yobbas2401/Sistema_de_monitoreo_de_fugas/Diagrama de conexiones/Programacion_inalambrica_de_Arduino_por_Bluetooth-768x578.jpg

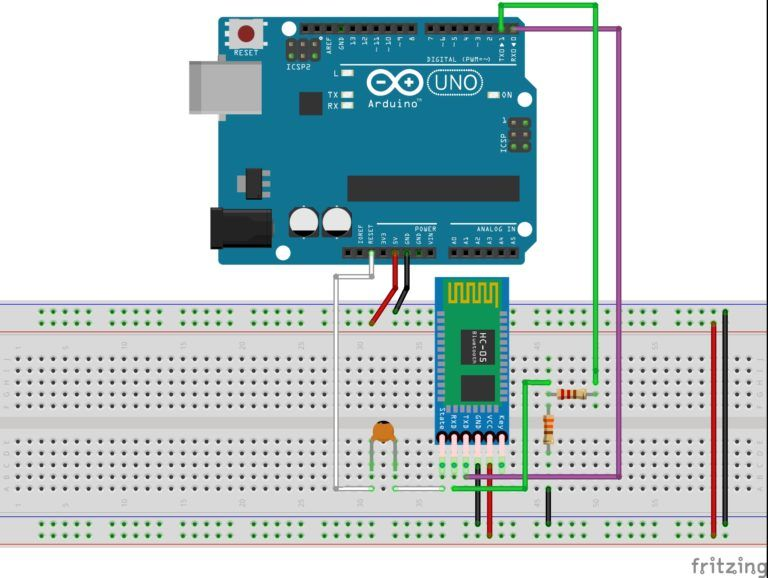
Diagrama de conexiones/Programacion_inalambrica_de_Arduino_por_Bluetooth-768x578.jpg
