yobbas2401/Sistema_de_monitoreo_de_fugas/README.md

# Sistema_de_monitoreo_de_fugas
Diseño de software para monitoreo de sensores
