yobbas2401/Sistema_de_monitoreo_de_fugas/instrumentos/CONVERTIDORES DE VOLTAJE A CORRIENTE.docx

CONVERTIDORES DE SEÑAL PARA RIEL DIN
NOMBRE | UBICACIÓN | PRECIO | MARCA
Acondicionador de señal de montaje sobre riel DIN (DRG-SC) | https://mx.omega.com/pptst/DRG-SC.html | 9,235.00 | OMEGA
Acondicionador de señales (DRF-PR) | https://mx.omega.com/pptst/DRF-PR.html | 5,190.00 | OMEGA
