yobbas2401/Sistema_de_monitoreo_de_fugas/instrumentos/sensor_presion/HL100D.pdf

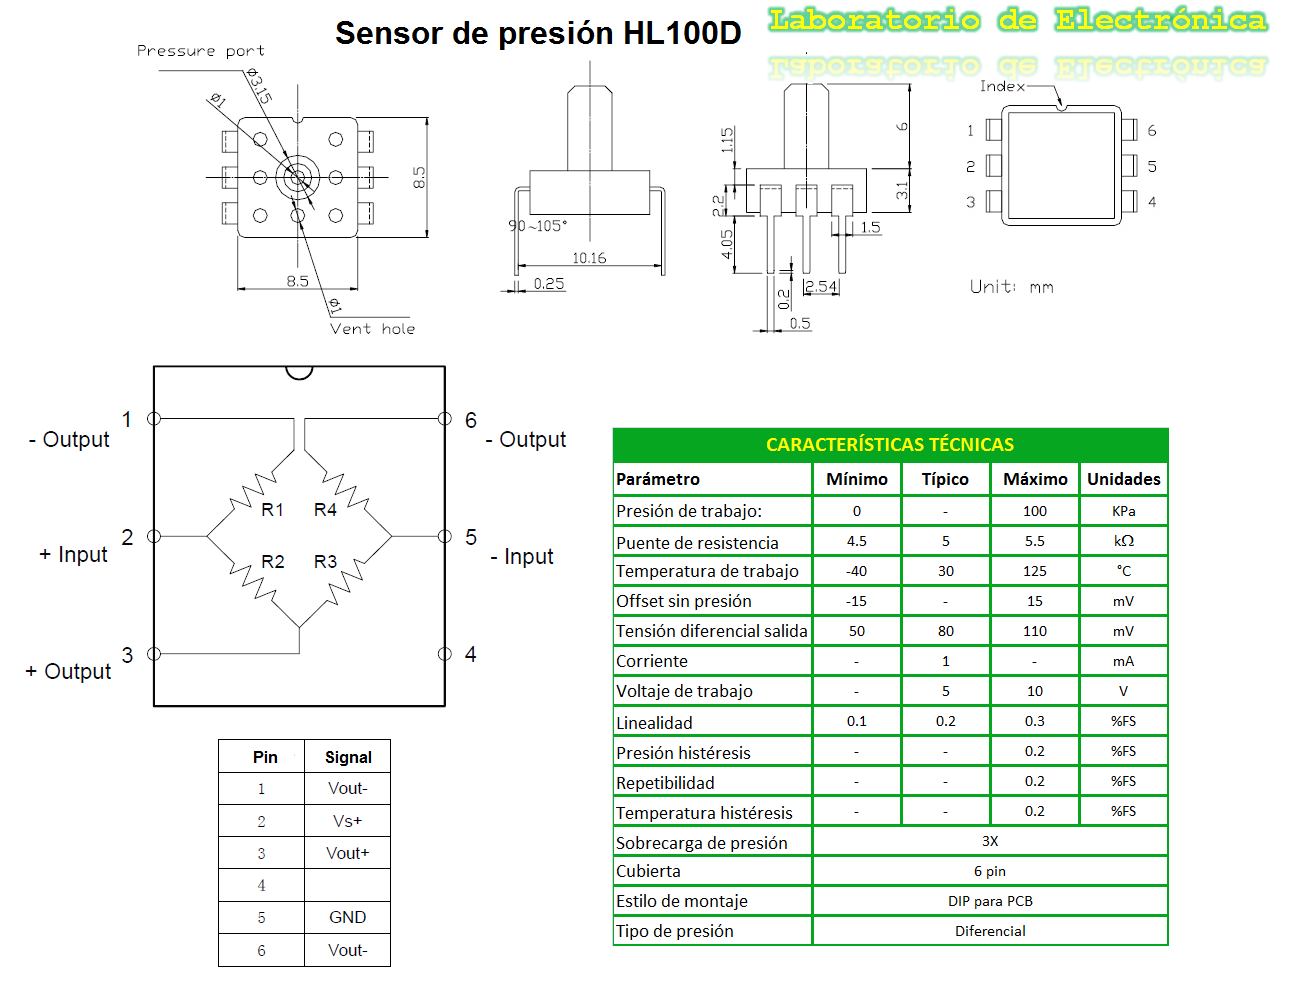
[picture p56: page 1]
