yobbas2401/Sistema_de_monitoreo_de_fugas/Diagrama de conexiones/9.jpg

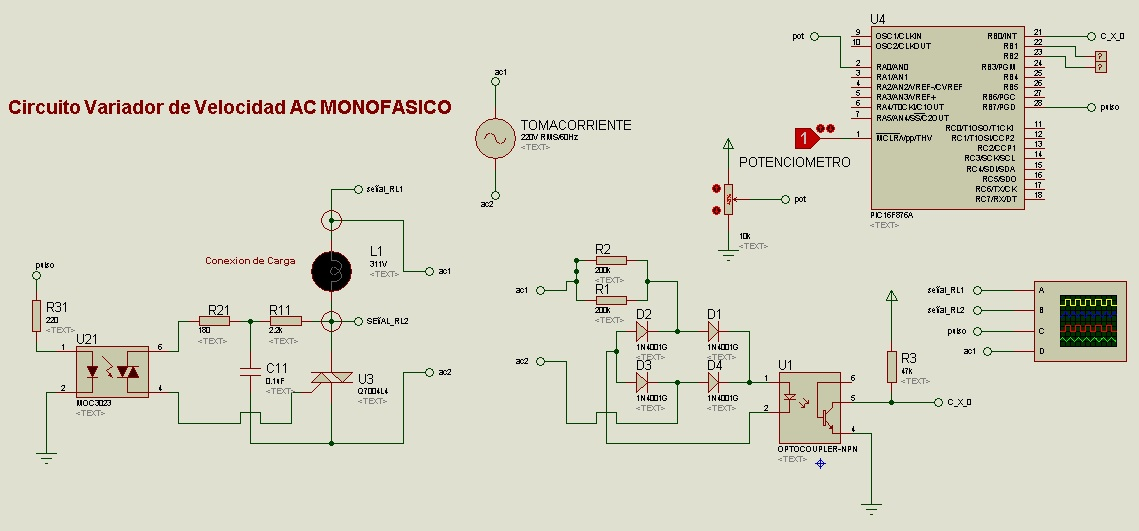
Diagrama de conexiones/9.jpg
