yobbas2401/Sistema_de_monitoreo_de_fugas/Diagrama de conexiones/dimmer_control_vel_motor.png

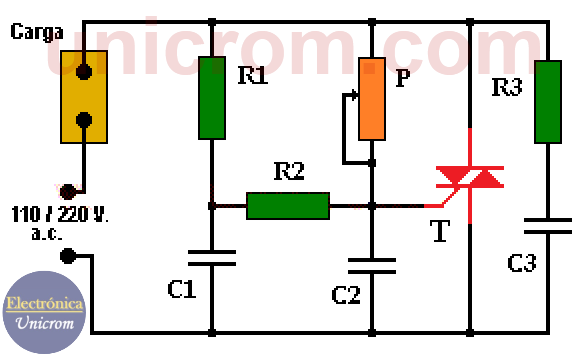
Diagrama de conexiones/dimmer_control_vel_motor.png
