yobbas2401/Sistema_de_monitoreo_de_fugas/instrumentos/LISTA DE COMPONENTES ELECTRONICOS.docx

Nombre | Ubicación | Precio | marca
Modulo dimmer ac para Arduino, 1 canal 127/220v 16a | https://articulo.mercadolibre.com.mx/MLM-606103804-modulo-dimmer-ac-para-arduino-1-canal-127220v-16a-_JM | 265
Sensor analógico, presión agua, aire 1.2 mpa rosca g 1/4 | https://articulo.mercadolibre.com.mx/MLM-553112386-sensor-analogico-5v-presion-agua-aire-12mpa-174psi-g14-_JM
Caudal metro sensor de flujo liquidos 1 pulgada 1 a 60 l/min | https://articulo.mercadolibre.com.mx/MLM-563607650-caudalimetro-sensor-de-flujo-liquidos-1-pulgada-1-a-60-lmin-_JM https://jdhlabstech.com/jdhshop/es/sensores-de-caudal-control/152-sensor-de-flujo-de-agua-caudalimetro-1-a-60-litrosmin-para-tuberia-de-1-pulgada.html | $348 $186.33 | SEA
Sensor de presión transductor gas/líquidos 0-5v. Acero inoxidable aplicaciones industriales. 100kpa / 200kpa / 500kpa/ 1mpa | https://jdhlabstech.com/jdhshop/es/sensores-de-presion/105-sensor-de-presion-para-gasliquidos-0-5v-cuerpo-de-acero-inoxidable-aplicaciones-industriales-100kpa-200kpa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 | $777.33
Convertidor de voltaje a corriente | https://articulo.mercadolibre.com.mx/MLM-636041373-knacro-voltaje-en-corriente-modulo-0-25v-33v-5v-10v-15v-2-_JM | $590 | KNACRO
Xtr110 | https://www.mouser.mx/ProductDetail/Texas-Instruments/XTR110KP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 | 369.28 | TEXAS INSTRUMENTS
Mpx5010 | https://www.mouser.mx/_/?Keyword=MPX5010&FS=True | 501.60 | NXP/FRRESCALE
