yobbas2401/Sistema_de_monitoreo_de_fugas/componentes hmi monitoreo de fugas labview/bomba_on.png

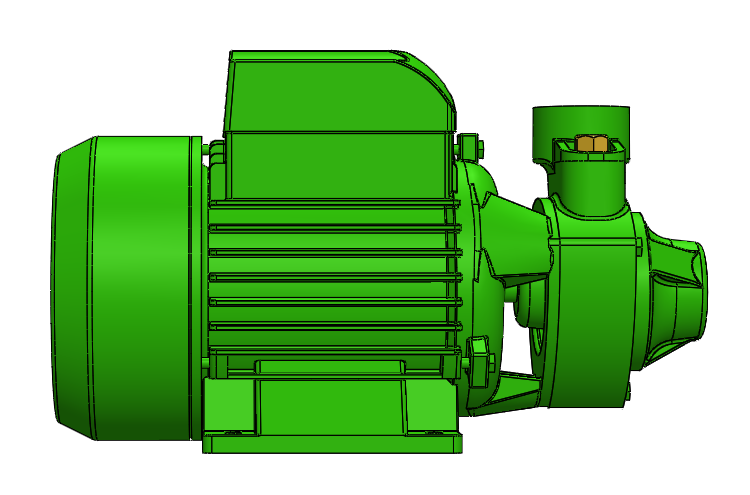
componentes hmi monitoreo de fugas labview/bomba_on.png
