yobbas2401/Sistema_de_monitoreo_de_fugas/componentes hmi monitoreo de fugas labview/sensor_flujo.png

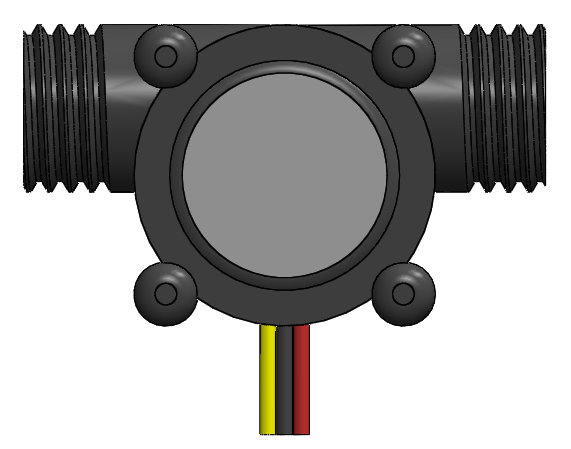
componentes hmi monitoreo de fugas labview/sensor_flujo.png
