yobbas2401/Sistema_de_monitoreo_de_fugas/Diselo 3d Prototipo Propuesto/BALL VALVE.SLDPRT

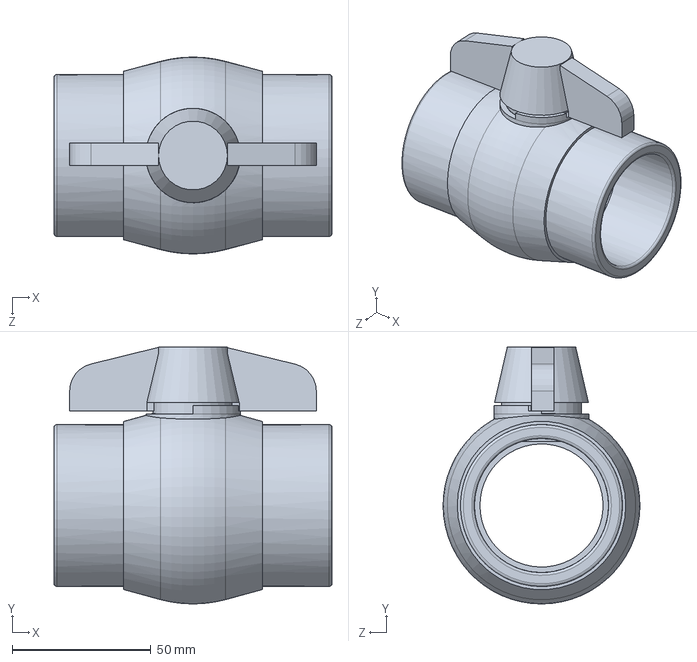
[picture p64: CAD file, 2022-07-13]
Diselo 3d Prototipo Propuesto/BALL VALVE.SLDPRT
100.0 x 92.4 x 70.8 mm
