yobbas2401/Sistema_de_monitoreo_de_fugas/Diselo 3d Prototipo Propuesto/baseTinaco.SLDPRT

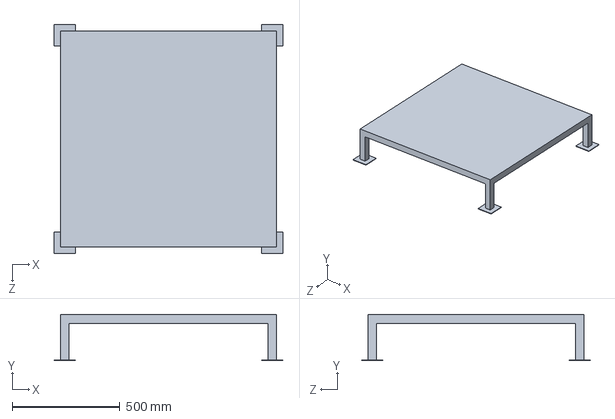
[picture p65: CAD file, 2022-07-13]
Diselo 3d Prototipo Propuesto/baseTinaco.SLDPRT
1061.9 x 214.4 x 1061.9 mm
