yobbas2401/Sistema_de_monitoreo_de_fugas/Diselo 3d Prototipo Propuesto/90deg LR Inch Elbow_Local4-Pipe_3-ProyectoDeteccionDeFugas.sldprt

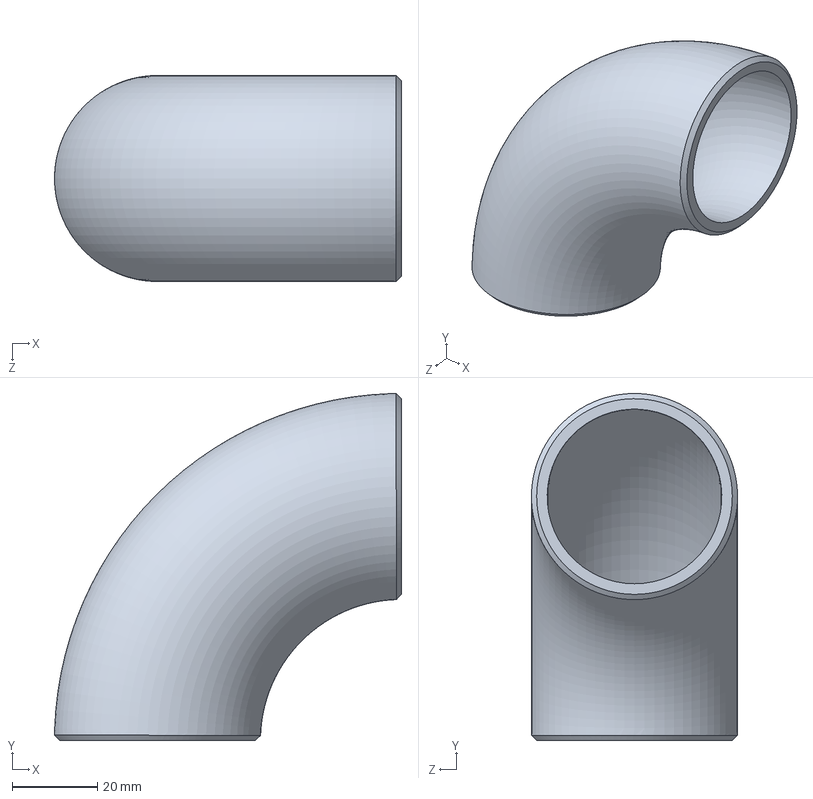
[picture p66: CAD file, 2022-07-13]
Diselo 3d Prototipo Propuesto/90deg LR Inch Elbow_Local4-Pipe_3-ProyectoDeteccionDeFugas.sldprt
81.3 x 81.3 x 48.3 mm
