yobbas2401/Sistema_de_monitoreo_de_fugas/Diselo 3d Prototipo Propuesto/90deg LR Inch Elbow_Local10-Pipe_3-ProyectoDeteccionDeFugas.sldprt

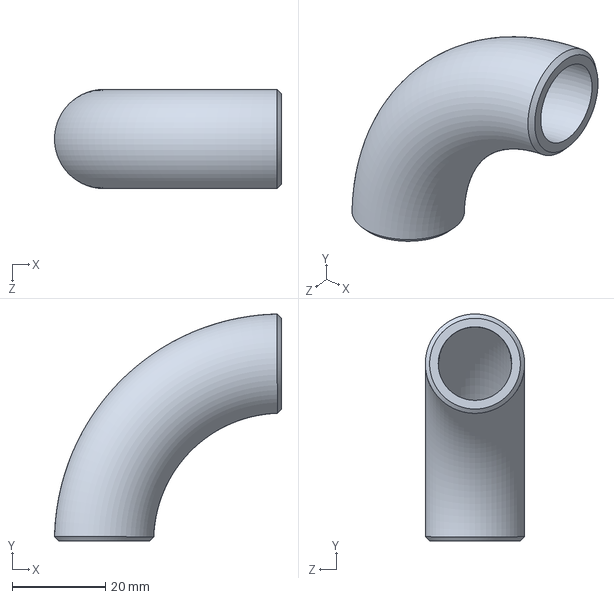
[picture p67: CAD file, 2022-07-13]
Diselo 3d Prototipo Propuesto/90deg LR Inch Elbow_Local10-Pipe_3-ProyectoDeteccionDeFugas.sldprt
48.8 x 48.8 x 21.3 mm
