yobbas2401/Sistema_de_monitoreo_de_fugas/Diselo 3d Prototipo Propuesto/baseBomba.SLDPRT

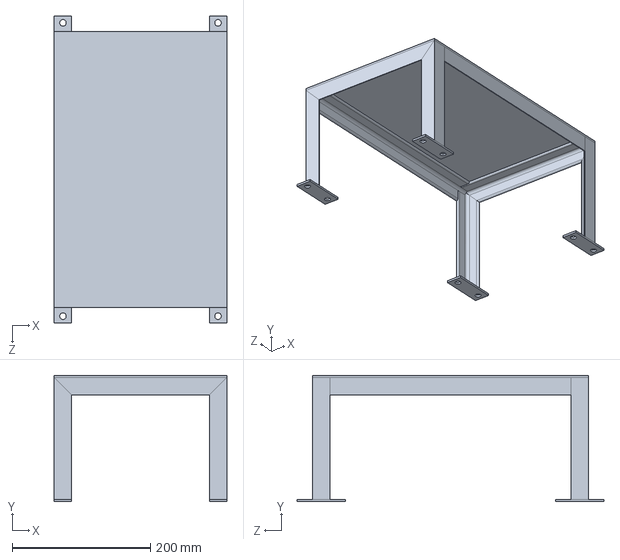
[picture p68: CAD file, 2022-07-13]
Diselo 3d Prototipo Propuesto/baseBomba.SLDPRT
250.0 x 183.2 x 444.6 mm
