yobbas2401/Sistema_de_monitoreo_de_fugas/Diselo 3d Prototipo Propuesto/birlo1.5in.SLDPRT

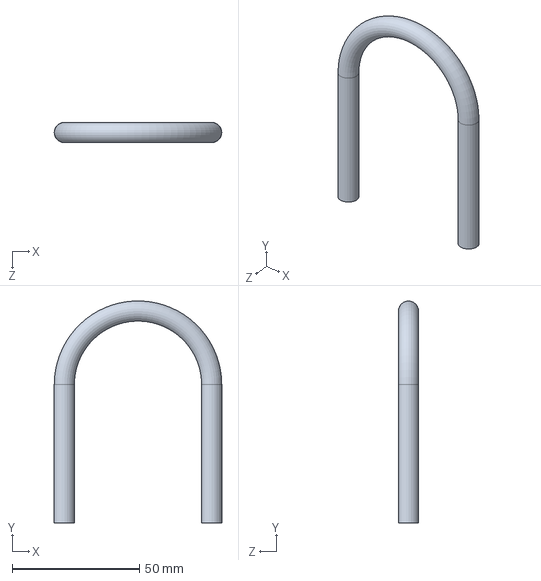
[picture p69: CAD file, 2022-07-13]
Diselo 3d Prototipo Propuesto/birlo1.5in.SLDPRT
65.9 x 87.3 x 7.94 mm
