yobbas2401/Sistema_de_monitoreo_de_fugas/Diselo 3d Prototipo Propuesto/birlo5in.SLDPRT

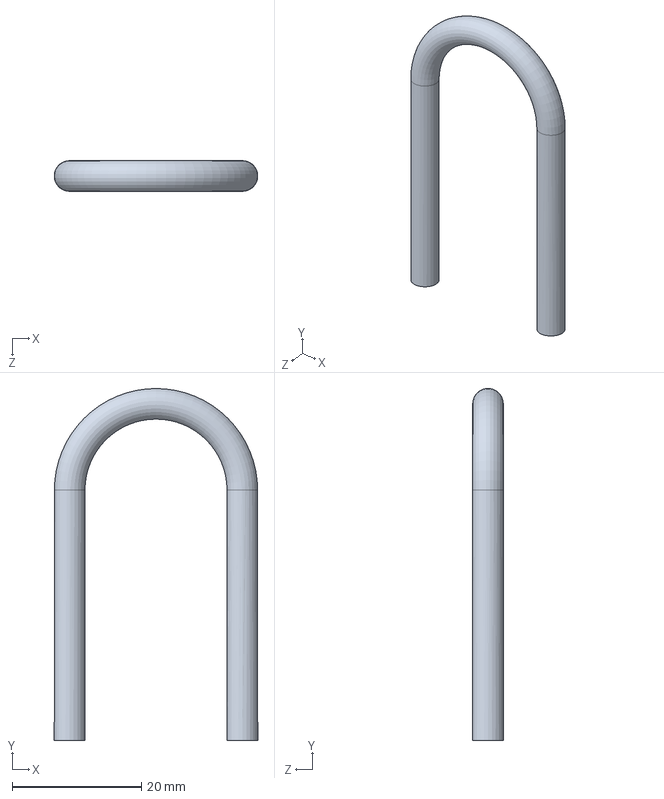
[picture p70: CAD file, 2022-07-13]
Diselo 3d Prototipo Propuesto/birlo5in.SLDPRT
31.5 x 54.5 x 4.76 mm
