yobbas2401/Sistema_de_monitoreo_de_fugas/Diselo 3d Prototipo Propuesto/6-32 oval head screw_GEO.SLDPRT

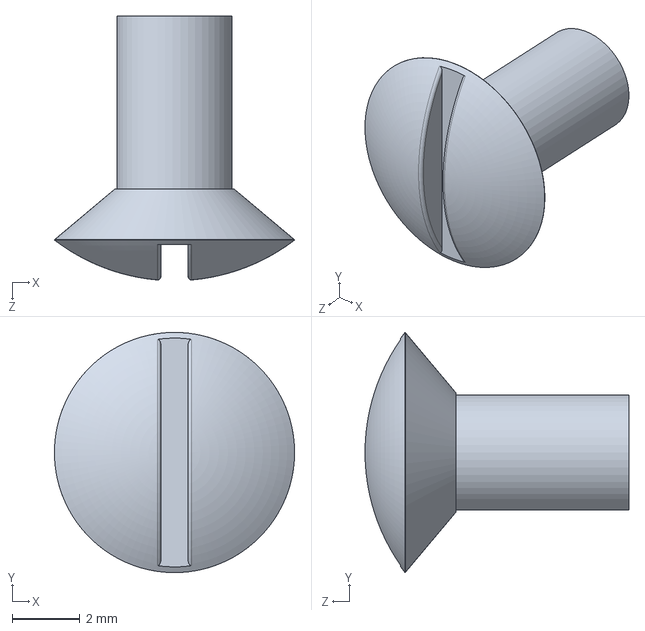
[picture p71: CAD file, 2022-07-13]
Diselo 3d Prototipo Propuesto/6-32 oval head screw_GEO.SLDPRT
7.09 x 7.09 x 7.79 mm
