yobbas2401/Sistema_de_monitoreo_de_fugas/(list of files, cad)

Other CAD files:
DTI/dti fugas.dwg
Diselo 3d Prototipo Propuesto/90deg LR Inch Elbow_Local7-Pipe_3-ProyectoDeteccionDeFugas.sldprt
Diselo 3d Prototipo Propuesto/90deg LR Inch Elbow_Local8-Pipe_3-ProyectoDeteccionDeFugas.sldprt
Diselo 3d Prototipo Propuesto/90deg lr inch elbow.sldprt
Diselo 3d Prototipo Propuesto/90deg LR Inch Elbow_Local9-Pipe_3-ProyectoDeteccionDeFugas.sldprt
Diselo 3d Prototipo Propuesto/90deg LR Inch Elbow_Local1-Pipe_3-ProyectoDeteccionDeFugas.sldprt
