yobbas2401/Sistema_de_monitoreo_de_fugas/DATOS MONITOREO EXCEL/28prueba1.xlsx

Untitled | Flujo de Salida | Flujo de entrada | Presion de Salida | Untitled 4
0.265615 | 25.778 | 28.444 | 8.914272 | 2693
0.426065 | 25.778 | 28.444 | 8.914272 | 2693
0.559048 | 25.778 | 28.444 | 8.914272 | 2693
0.666177 | 25.778 | 28.444 | 8.914272 | 2693
0.761197 | 25.778 | 28.444 | 8.914272 | 2693
0.856565 | 25.778 | 28.444 | 8.914272 | 2693
0.959565 | 1.778 | 1.778 | 1.338514 | 2693
1.057328 | 1.778 | 1.778 | 1.338514 | 2693
1.142428 | 1.778 | 1.778 | 1.338514 | 2693
1.209166 | 1.778 | 1.778 | 1.338514 | 2693
1.262976 | 1.778 | 1.778 | 1.338514 | 2693
1.315032 | 1.778 | 1.778 | 1.827273 | 2693
1.366753 | 1.778 | 1.778 | 1.827273 | 2693
1.418604 | 1.778 | 1.778 | 1.827273 | 2693
1.471571 | 1.778 | 1.778 | 1.827273 | 2693
1.526627 | 1.778 | 1.778 | 1.827273 | 2693
1.583228 | 1.778 | 1.778 | 1.827273 | 2693
1.638201 | 1.778 | 1.778 | 0.849756 | 2693
1.690639 | 1.778 | 1.778 | 0.849756 | 2693
1.743635 | 1.778 | 1.778 | 0.849756 | 2693
1.796049 | 1.778 | 1.778 | 0.849756 | 2693
1.848729 | 1.778 | 1.778 | 0.849756 | 2693
1.902012 | 1.333 | 1.778 | 0.849756 | 2693
1.954794 | 1.333 | 1.778 | 0.116618 | 2693
2.008945 | 1.333 | 1.778 | 0.116618 | 2693
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
