yobbas2401/Sistema_de_monitoreo_de_fugas/DATOS MONITOREO EXCEL/prueba1-28L.xlsx

Tiempo | Flujo de Salida | Flujo de Entrada | Presion de salida
0.074045 | 19.556 | 21.333 | 2.438221
0.161962 | 19.556 | 21.333 | 2.438221
0.250429 | 19.556 | 21.333 | 2.438221
0.338884 | 19.556 | 21.333 | 2.438221
0.439045 | 19.556 | 21.333 | 2.438221
0.613845 | 0.889 | 0.889 | 2.071652
0.786383 | 0.889 | 0.889 | 2.071652
0.946398 | 0.889 | 0.889 | 2.071652
1.022477 | 0.889 | 0.889 | 2.071652
1.083714 | 17.778 | 20.889 | 7.936755
1.153343 | 17.778 | 20.889 | 7.936755
1.268623 | 26.222 | 28.444 | 9.280841
1.402363 | 26.222 | 28.444 | 9.280841
1.541516 | 26.222 | 28.444 | 9.280841
1.660845 | 25.778 | 28.444 | 9.280841
1.762815 | 25.778 | 28.444 | 9.280841
1.867005 | 25.778 | 28.444 | 9.280841
1.969363 | 26.222 | 28.444 | 8.792082
2.072104 | 26.222 | 28.444 | 8.792082
2.172739 | 26.222 | 28.444 | 8.792082
2.274572 | 25.778 | 28.444 | 8.914272
2.375341 | 25.778 | 28.444 | 8.914272
2.474814 | 25.778 | 28.444 | 8.914272
2.574619 | 25.778 | 28.444 | 9.158651
2.674757 | 25.778 | 28.444 | 9.158651
2.775183 | 25.778 | 28.444 | 9.158651
2.87831 | 25.778 | 28.444 | 10.380547
2.981501 | 25.778 | 28.444 | 10.380547
3.086136 | 25.778 | 28.444 | 10.380547
3.191849 | 26.222 | 28.444 | 9.158651
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
