yobbas2401/Sistema_de_monitoreo_de_fugas/DATOS MONITOREO EXCEL/prueba2-28L.xlsx

Tiempo | Flujo de Salida | Flujo de entrada | Presion de Salida
0.122445 | 25.333 | 28.444 | 9.52522
0.229185 | 25.333 | 28.444 | 9.52522
0.334736 | 25.333 | 28.444 | 9.52522
0.43852 | 25.333 | 28.444 | 9.52522
0.5408 | 25.333 | 28.444 | 9.52522
0.642136 | 25.333 | 28.444 | 9.52522
0.744385 | 0 | 0.444 | -0.49433
0.851754 | 0 | 0.444 | -0.49433
0.946339 | 0 | 0.444 | -0.49433
1.027718 | 0 | 0.444 | -0.49433
1.0875 | 0 | 0.444 | -0.49433
1.146241 | 0 | 0 | 0.605376
1.208471 | 0 | 0 | 0.605376
1.268726 | 0 | 0 | 0.605376
1.330154 | 0 | 0 | 0.605376
1.386072 | 0 | 0 | 0.605376
1.442679 | 0 | 0 | 0.605376
1.498771 | 0 | 0 | 0.605376
1.552111 | 0 | 0 | 0.605376
1.605717 | 0 | 0 | 0.605376
1.659124 | 0 | 0 | 0.605376
1.711453 | 0 | 0 | 0.605376
1.76639 | 4 | 4.889 | 5.859531
1.827572 | 4 | 4.889 | 5.859531
1.890848 | 4 | 4.889 | 5.859531
1.955989 | 4 | 4.889 | 5.859531
2.016052 | 4 | 4.889 | 5.859531
2.081375 | 23.556 | 26.667 | 8.058944
2.158656 | 23.556 | 26.667 | 8.058944
2.247486 | 23.556 | 26.667 | 8.058944
2.347734 | 25.778 | 28.889 | 9.280841
2.452601 | 25.778 | 28.889 | 9.280841
2.560441 | 25.778 | 28.889 | 9.280841
2.670618 | 26.222 | 28.444 | 9.280841
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
