yobbas2401/Sistema_de_monitoreo_de_fugas/DATOS MONITOREO EXCEL/prueba3-20L.xlsx

Tiempo | Flujo de Salida | Flujo deEntrada | Presion de Salida
0.056684 | 11.111 | 12.444 | 0.971945
0.124178 | 11.111 | 12.444 | 0.971945
0.194986 | 11.111 | 12.444 | 0.971945
0.26759 | 11.111 | 12.444 | 0.971945
0.342437 | 11.111 | 12.444 | 0.971945
0.421778 | 11.111 | 12.444 | 0.971945
0.500591 | 11.111 | 12.444 | 0.971945
0.579438 | 11.111 | 12.444 | 0.971945
0.652092 | 11.111 | 12.444 | 0.971945
0.739557 | 1.333 | 1.333 | 3.904497
0.8269 | 1.333 | 1.333 | 3.904497
0.909648 | 1.333 | 1.333 | 3.904497
0.976921 | 1.333 | 1.333 | 3.904497
1.033089 | 1.333 | 1.333 | 3.904497
1.112272 | 16.444 | 18.667 | 5.370772
1.21979 | 16.444 | 18.667 | 5.370772
1.339038 | 19.111 | 21.333 | 5.615152
1.457412 | 19.111 | 21.333 | 5.615152
1.550277 | 19.111 | 21.333 | 5.615152
1.642784 | 19.556 | 22.222 | 4.515445
1.735255 | 19.556 | 22.222 | 4.515445
1.827011 | 19.556 | 22.222 | 4.515445
1.919011 | 20 | 21.778 | 5.737341
2.010767 | 20 | 21.778 | 5.737341
2.101601 | 20 | 21.778 | 5.737341
2.191779 | 20 | 21.778 | 5.737341
2.281242 | 19.556 | 21.778 | 5.248583
2.370624 | 19.556 | 21.778 | 5.248583
2.460666 | 19.556 | 21.778 | 5.248583
2.553372 | 19.111 | 21.778 | 5.126393
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
