yobbas2401/Sistema_de_monitoreo_de_fugas/DATOS MONITOREO EXCEL/prueba4-20L.xlsx

Tiempo | Flujo de Salida | Flujo de Entrada | Presion de Salida
0.29607 | 19.556 | 21.333 | 5.737341
0.755666 | 1.333 | 1.778 | 3.782307
1.092309 | 1.333 | 1.778 | 3.782307
1.341842 | 1.333 | 1.778 | 3.782307
1.45153 | 1.333 | 1.778 | 3.782307
1.509745 | 1.333 | 1.778 | 3.782307
1.588816 | 16.444 | 18.222 | 6.10391
1.676319 | 16.444 | 18.222 | 6.10391
1.770999 | 16.444 | 18.222 | 6.10391
1.859364 | 19.556 | 21.778 | 5.615152
1.943267 | 19.556 | 21.778 | 5.615152
2.031053 | 19.556 | 21.778 | 5.615152
2.195897 | 19.111 | 21.778 | 5.248583
2.381277 | 19.111 | 21.778 | 5.248583
2.565804 | 19.111 | 21.778 | 5.248583
2.694869 | 19.556 | 21.778 | 7.203617
2.783911 | 19.556 | 21.778 | 7.203617
2.873325 | 19.556 | 21.778 | 7.203617
2.96218 | 19.556 | 21.778 | 7.203617
3.050087 | 19.556 | 21.333 | 6.10391
3.139452 | 19.556 | 21.333 | 6.10391
3.245979 | 19.556 | 21.778 | 5.126393
3.361101 | 19.556 | 21.778 | 5.126393
3.479873 | 19.556 | 21.778 | 5.126393
3.606191 | 19.556 | 21.778 | 3.171359
3.719345 | 19.556 | 21.778 | 3.171359
3.832696 | 19.556 | 21.778 | 3.171359
3.949155 | 19.556 | 21.778 | 5.248583
4.126444 | 19.111 | 21.333 | 5.615152
4.304211 | 19.111 | 21.333 | 5.615152
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
