yobbas2401/Sistema_de_monitoreo_de_fugas/DTI/DTI4.pdf

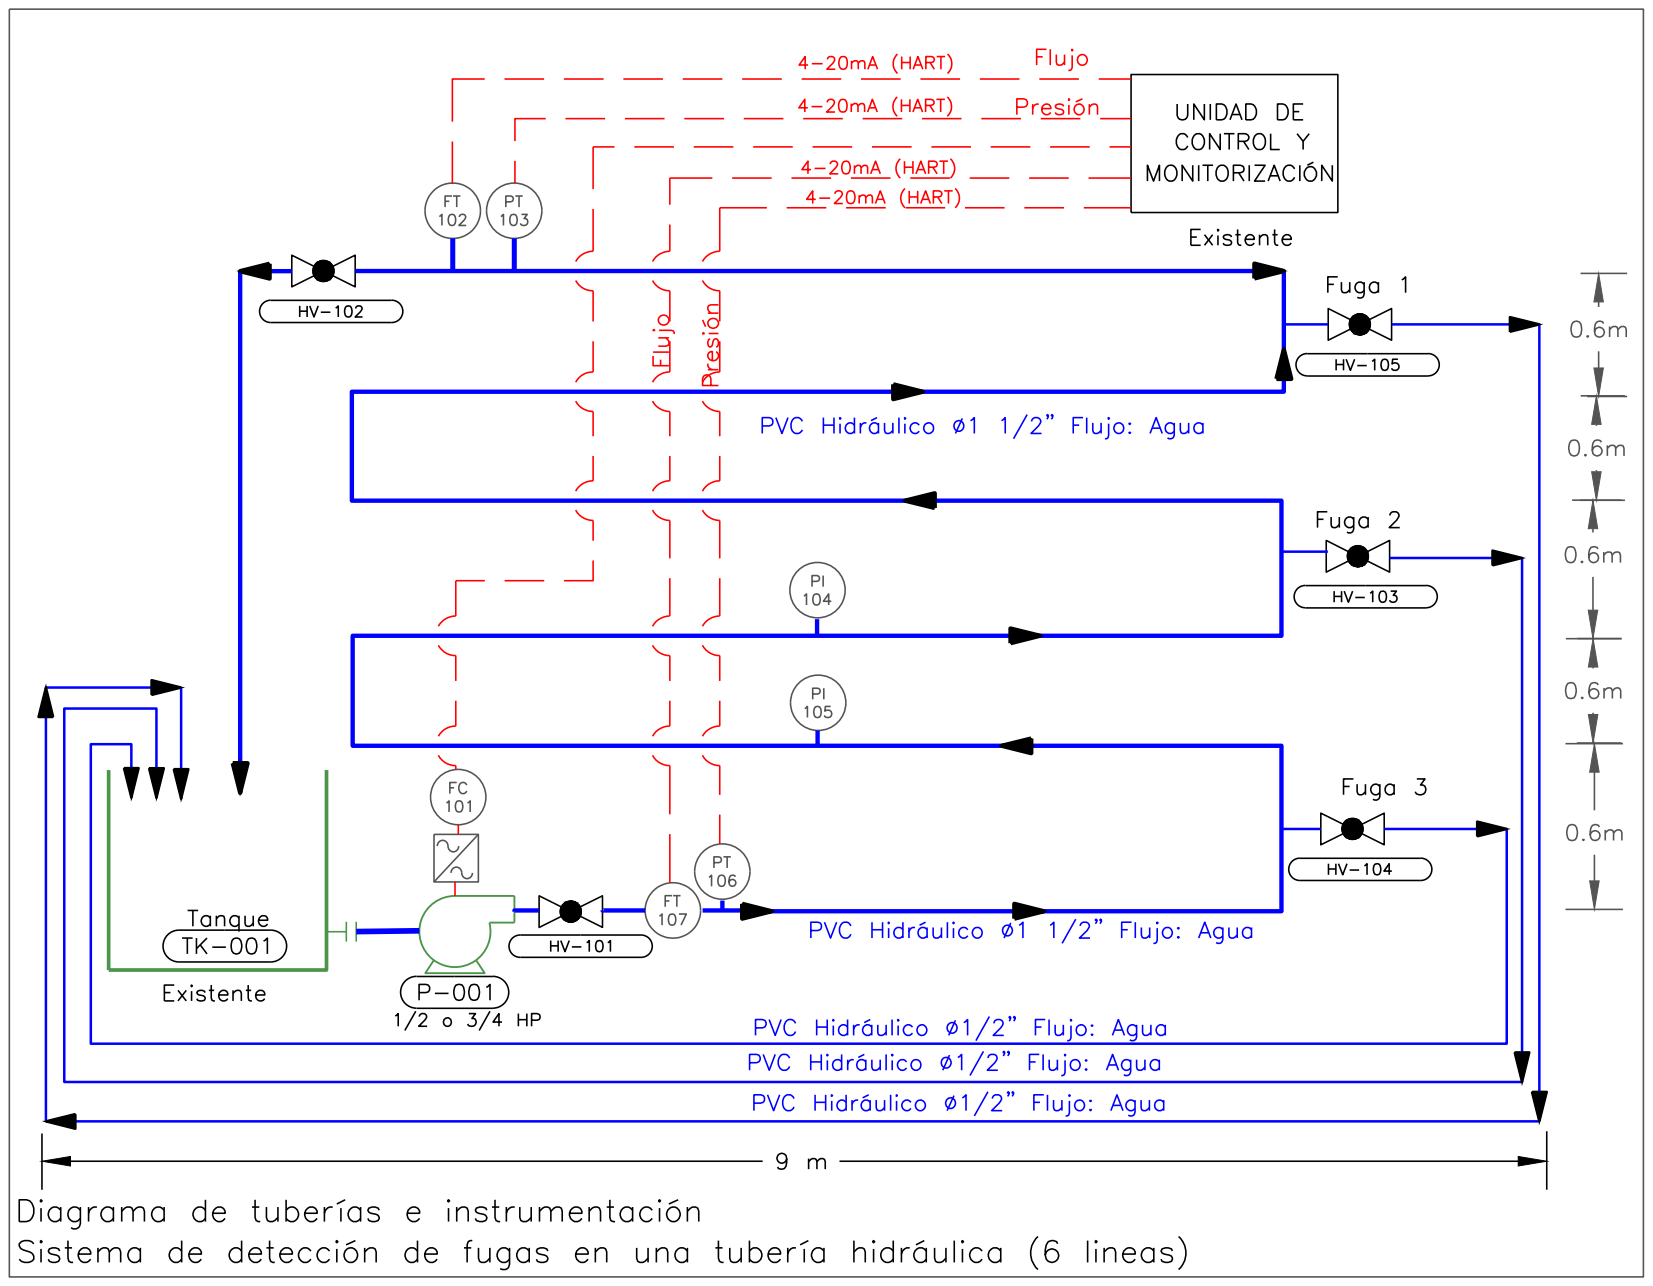
[picture p72: page 1]
