yobbas2401/Sistema_de_monitoreo_de_fugas/DTI/DTI6lineas.pdf

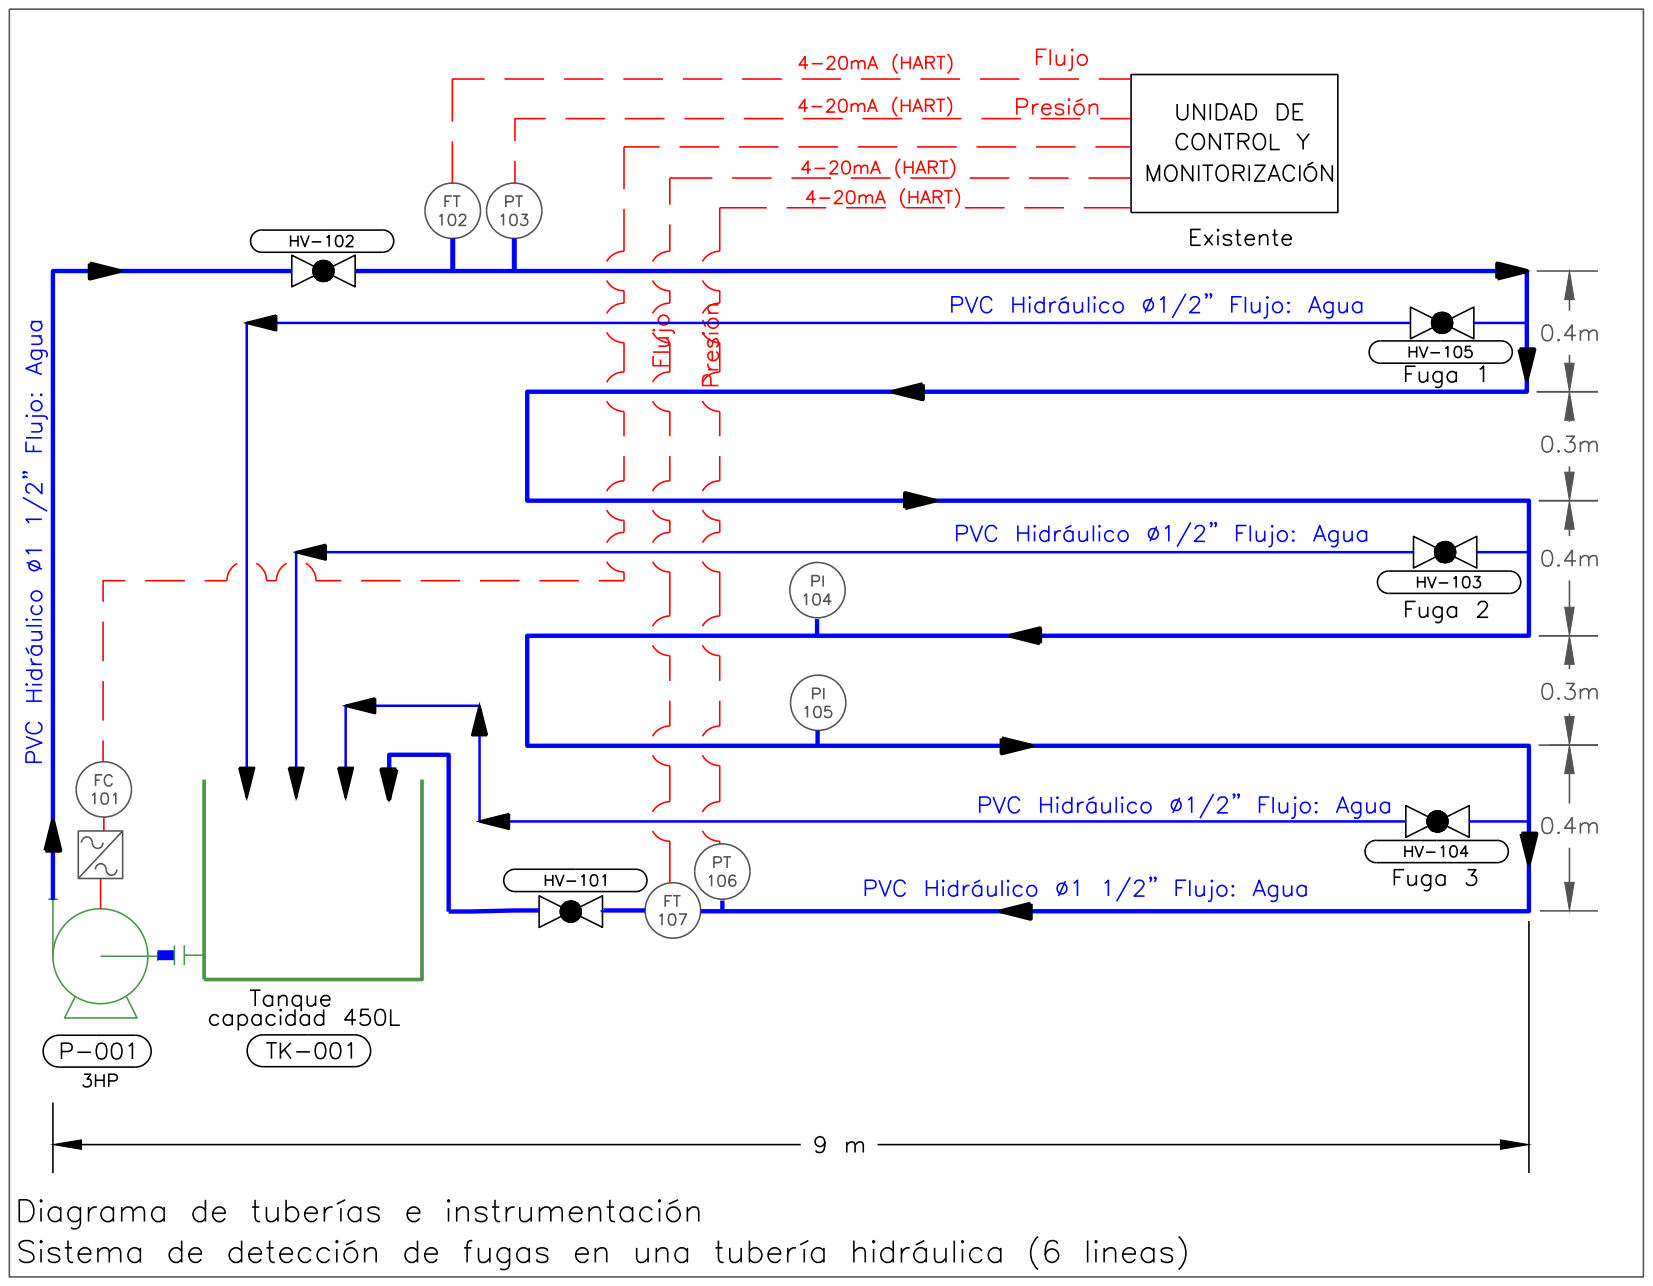
[picture p73: page 1]
